Franzelfx/vertical-wind-turbine/datasheets/README.md

# Datasheets

| File | Part | Revision |
| --- | --- | --- |
| `datasheets/bq25798-SLUSDV2C.pdf` | TI BQ25798 | SLUSDV2C, June 2026 |
| `datasheets/ap63203-diodes.pdf` | Diodes AP63203 | as downloaded 2026-11-06 |

Others to add when parts are chosen (`plans/electronics.md`, E2).
