Franzelfx/vertical-wind-turbine/firmware/README.md

# Firmware

Nothing here yet: `plans/electronics.md`, phase E4. ESP32-C3 on the charge board, see ADR-007.

The board charges without firmware, at the charger's defaults, and is protected without it (ADR-006).
