Franzelfx/vertical-wind-turbine/plans/requirements.md

# Requirements

> Generated by `uv run vawt docs` from `src/vawt/system/requirements.py`; do not edit by hand. Change a
> requirement there. `tests/test_requirements.py` fails when a limit is broken.

Goal: charge a 3S Li-ion pack from a small printed turbine on an 80 x 80 mm, 3 m wooden pier, with
everything needed in one weatherproof enclosure.

Evidence: **M** measured from a real file, **S** from a named source, **E** an estimate. Everything
holds on paper only: nothing has been built yet.

| ID | Requirement | Limit | Now | Holds | Evidence |
| --- | --- | --- | --- | --- | --- |
| SYS1 | Charge voltage: 3S Li-ion, the `12 V` pack in the brief | <= 12.6 V | 12.6 V | yes | S |
| SYS2 | Mean wind fills the pack in | <= 14 days | 7.349 days | yes | E |
| SYS3 | Pack drain with the rotor standing: charger, regulator, MCU, BMS | <= 1 mW | 0.5457 mW | yes | E |
| SYS4 | Wind at which charging begins | <= 4 m/s | 2.8 m/s | yes | E |
| SYS5 | Wind at which the rotor starts against cogging and drag | <= 3 m/s | 2.129 m/s | yes | E |
| ELE1 | Relay trips below the charger's overvoltage stop | <= 26 V | 22.5 V | yes | E |
| ELE2 | Open-circuit bus at survival wind, within the 100 V parts | <= 100 V | 70.8 V | yes | E |
| ELE3 | Relay series resistors at survival wind | <= 9 W | 5.762 W | yes | E |
| ELE4 | Generator current at peak power, within the motor's rating | <= 1.5 A | 1.031 A | yes | E |
| ELE5 | Generator copper loss at peak power | <= 12 W | 11.7 W | yes | E |
| ELE6 | Charger input current at peak power | <= 3.3 A | 1.031 A | yes | S |
| MEC1 | Rotor tip to pier face | >= 15 mm | 17.5 mm | yes | M |
| MEC2 | Rotor underside above ground, out of reach | >= 2000 mm | 2010 mm | yes | M |
| MEC3 | Longest printed enclosure part on the print bed | <= 256 mm | 244 mm | yes | M |
| MEC4 | Enclosure screws stay on the pier's face | <= 80 mm | 72.5 mm | yes | M |
| MEC5 | Pier utilisation at survival wind, EN 1995 style | <= 1 | 0.6853 | yes | E |
| MEC6 | Swing at the rotor when imbalance sits on the pier's first mode | <= 5 mm | 1.26 mm | yes | E |
| MEC7 | Bracket arm bending at survival wind, ASA with layer knock-down | <= 10 MPa | 2.415 MPa | yes | E |
| MEC8 | M8 stub bending at survival wind, A2-70 | <= 200 MPa | 40.3 MPa | yes | E |
| MEC9 | Wind at which a free-running rotor reaches its speed limit: lock it above | >= 20 m/s | 24.05 m/s | yes | E |
| ENC1 | Gasket squeeze, lower bound | >= 20 % | 26.67 % | yes | M |
| ENC2 | Gasket squeeze, upper bound | <= 35 % | 26.67 % | yes | M |
| ENC3 | Tallest board part to the lid's inner face | >= 5 mm | 22.9 mm | yes | M |
