Franzelfx/vertical-wind-turbine/docs/assumptions.md

# Assumptions

> Generated by `uv run vawt docs` from the `ASSUMPTION` comments in `src/vawt/spec.py`; do not edit by
> hand (`tests/test_docs.py` fails when this page and the code drift apart).

Each line is a number nobody has measured. `plans/bench.md` names each test.

| Value | Assumption and the test that replaces it |
| --- | --- |
| `mean_wind_m_s = 3.5` | 3 m mast in a garden; replace with a site log (B5) |
| `survival_wind_m_s = 30.0` | 11 Bft gust, typical inland Germany upper bound |
| `cp_max = 0.12` | replace with the torque-speed curve from bench test B3 |
| `tsr_opt = 0.8` | typical of drag rotors; B3 |
| `tsr_no_load = 1.6` | twice tsr_opt, parabolic model; B3 |
| `max_rpm = 3000.0` | bench spin test B4 sets the real limit |
| `damping_q = 20.0` | timber pier, about 2.5 % damping; B5 |
| `imbalance_g_mm = 500.0` | 5 g at 100 mm for an unbalanced print; B4 |
| `resistance_ll_ohm = 11.0` | no published figure found; measure, B1 |
| `inductance_ll_h = 0.005` | B1 |
| `cogging_nm = 0.012` | low for a 24N22P gimbal motor; B1 |
| `drag_nm = 0.010` | three bearings plus iron loss; B1 |
| `copper_limit_w = 12.0` | thermal limit of a 124 g motor in free air; B2 |
| `efficiency = 0.85` | at light load and large step; B2 |
| `cell_ah = 3.5` | LG MJ1 / Samsung 35E class; check the bought pack |
| `phone_wh = 15.0` | a typical smartphone battery; a yardstick only |
| `solar_kwh_per_kwp = 950.0` | fixed panel in Germany; a yardstick only |
| `electricity_eur_kwh = 0.35` | German household price; a yardstick only |
