Franzelfx/vertical-wind-turbine/docs/sizing.md

# Sizing

> Generated by `uv run vawt docs` from `src/vawt/system/sizing.py` and `src/vawt/spec.py`; do not
> edit by hand (`tests/test_docs.py` fails when this page and the code drift apart).

**Accuracy: treat every power figure as +-50 % until bench tests B1 and B3 (`plans/bench.md`) replace
the rotor and generator assumptions.** Nothing has been built yet.

## Rotor and generator

Rotor: 245 mm x 890 mm, swept 0.216 m2,
1.69 kg at the slicer's settings. Cp 0.12 at tip speed ratio
0.8. Generator: GM4108H-120T, 52.85 rpm/V,
11 ohm line to line.

Starts at 2.1 m/s, charges from 2.8 m/s.

Best point with ideal input-voltage tracking, inside every limit: the charger's 3.6 V
minimum, the relay's 22.5 V trip, and the generator's 1.5 A and 12 W copper limits:

| Wind (m/s) | Rotor (rpm) | Torque (N m) | Current (A) | Bus (V) | Copper loss (W) | Into the pack (W) |
| --- | --- | --- | --- | --- | --- | --- |
| 3 | 252 | 0.004 | 0.02 | 3.6 | 0.0 | 0.1 |
| 4 | 304 | 0.020 | 0.11 | 3.6 | 0.1 | 0.3 |
| 5 | 406 | 0.032 | 0.18 | 4.8 | 0.4 | 0.7 |
| 6 | 513 | 0.045 | 0.25 | 6.1 | 0.7 | 1.3 |
| 8 | 731 | 0.073 | 0.40 | 8.5 | 1.8 | 2.9 |
| 10 | 956 | 0.103 | 0.57 | 10.9 | 3.6 | 5.2 |
| 12 | 1184 | 0.136 | 0.75 | 13.2 | 6.2 | 8.3 |
| 15 | 1534 | 0.187 | 1.03 | 16.8 | 11.7 | 14.5 |
| 18 | 0 | 0.000 | 0.00 | 0.0 | 0.0 | 0.0 |
| 20 | 0 | 0.000 | 0.00 | 0.0 | 0.0 | 0.0 |

**Peak: 19.1 W into the pack, at 17.0 m/s.** Charging runs from 2.8 to 17.1 m/s. Above about 10 m/s the generator limits the output, not the rotor: its resistance would turn more power into heat than the motor can shed, so firmware lets the rotor run faster at lower torque.

## Yield

Rayleigh wind distribution. The site assumption is 3.5 m/s mean: a 3 m pole in a
garden. A site log (B5) replaces it. Pack: 76 Wh.

| Mean wind (m/s) | Mean power (W) | Energy (kWh/year) | Days to fill the pack |
| --- | --- | --- | --- |
| 2.5 | 0.13 | 1.1 | 25 |
| 3.5 | 0.43 | 3.8 | 7 |
| 4.5 | 0.93 | 8.2 | 3 |
| 5.5 | 1.64 | 14.4 | 2 |

## Overvoltage

The free-running rotor drives the bus past the charger's 24 V at
10.2 m/s, which happens whenever the pack is full, and reaches
71 V at 30 m/s. The relay trips at
22.5 V, below the charger's 26 V stop (ADR-006). Its coil path
draws 144 mW at a 12 V bus, about 2 % of what the rotor makes there.

## Stopping the rotor

The brake switch shorts the bus through 4.7 ohm. It only slows the rotor: at 10 m/s
it holds 817 rpm with 9.5 W in the generator, and the
generator's 12 W limit is reached at 10.9 m/s.
Free-running, the rotor reaches its assumed 3000 rpm limit at
24.1 m/s. **Lock it with the parking pin before a forecast
storm (ADR-005).**

## Structure, at 30 m/s

| Item | Value |
| --- | --- |
| Rotor drag | 143 N |
| Pier drag | 198 N |
| Moment at the pier's base | 648 N m |
| Bending stress at the base | 7.6 MPa |
| Pier utilisation | 0.69 |
| Deflection at rotor height | 33 mm |
| Bracket arm stress | 2.4 MPa |
| M8 stub stress | 40 MPa |

## Vibration

The pier's first mode is 4.9 Hz, which is 296 rpm. The rotor
reaches that speed at 4.7 m/s at its best tip speed ratio, inside the everyday
range. With the assumed 500 g mm of imbalance the swing is
1.3 mm at resonance, small but continuous at the wind you will see most.
Balance the rotor (B4). If it shakes, guy wires move the mode to about
31 Hz, near the rotor's running range at high wind, so check
again then. Assumed: Q = 20.

## Power budget with no wind

0.55 mW from the pack: 76 Wh lasts
5772 days. Li-ion's own self-discharge is the larger term.

Charging stops outside 0-45 degC, by the NTC on
the pack (TS pin). In a German winter that means no charging on frosty days.
