Franzelfx/vertical-wind-turbine/docs/bom.md

# Board parts

> Generated by `tools/bom.py` from the KiCad netlist and JLCPCB's public catalogue; do not edit by hand
> (`tests/test_electronics.py` fails when a part in the schematic is missing here).

Stock and prices as of 2026-11-06, single-unit tier.

**Parts total: about 11.83 USD per board**, without the fab, assembly, and what is listed below.
Datasheet checks so far: ADR-007.

| Parts | Qty | Value | LCSC | Manufacturer's part | Stock | Unit price (USD) | Line |
| --- | --- | --- | --- | --- | --- | --- | --- |
| C1 | 1 | 100n 100V | C107181 | CC1206KKX7R0BB104 | 68,519 | 0.0402 | 0.04 |
| C13 C14 C15 C16 C17 C19 C20 C23 C24 C28 | 10 | 10u 25V | C5448891 | TCC0805X5R106K250FT | 183,339 | 0.0290 | 0.29 |
| C12 C18 C2 C22 C29 C8 | 6 | 100n | C14663 | CC0603KRX7R9BB104 | 34,754,599 | 0.0093 | 0.06 |
| C21 | 1 | 1n 50V | C100040 | CC0603KRX7R9BB102 | 2,016,034 | 0.0085 | 0.01 |
| C25 C26 | 2 | 22u | C380336 | TCC0805X5R226K100FT | 79,273 | 0.0477 | 0.10 |
| C27 | 1 | 1u | C1592 | CL10A105KO8NNNC | 1,921,364 | 0.0109 | 0.01 |
| C3 C4 | 2 | 47n | C107093 | CC0603KRX7R9BB473 | 1,311,137 | 0.0083 | 0.02 |
| C5 | 1 | 4u7 | C380325 | TCC0603X5R475K160CT | 945,252 | 0.0109 | 0.01 |
| C10 C11 C6 C7 C9 | 5 | 10u 35V | C6119957 | CGA1206X5R106K350NT | 17,421 | 0.0878 | 0.44 |
| D1 D2 D3 D4 D5 D6 | 6 | SS510 | C19229 | SS510C | 24,495 | 0.1137 | 0.68 |
| D10 | 1 | MMSZ5225B | C22399894 | MMSZ5225B | 14,811 | 0.0190 | 0.02 |
| D11 | 1 | green | C12624 | KT-0603G | 348,198 | 0.0119 | 0.01 |
| D7 | 1 | 1SMB5927B | C53171 | 1SMB5927BT3G | 31,381 | 0.1377 | 0.14 |
| D8 | 1 | MMSZ5240B | C151060 | MMSZ5240B-7-F | 40,197 | 0.0277 | 0.03 |
| D9 | 1 | SMBJ26CA | C123932 | SMBJ26CA | 97,352 | 0.0398 | 0.04 |
| J1 | 1 | GENERATOR | C474953 | KF128-5.08-3P-AA | 17,624 | 0.3175 | 0.32 |
| J2 J4 J5 | 3 | BRAKE | C474952 | KF128-5.08-2P-AA | 74,170 | 0.1927 | 0.58 |
| J3 | 1 | PACK_NTC | C158012 | B2B-XH-A(LF)(SN) | 597,562 | 0.0408 | 0.04 |
| J6 | 1 | USB-C | C165948 | TYPE-C-31-M-12 | 322,268 | 0.1870 | 0.19 |
| K1 | 1 | SRD-12VDC-SL-C | C30431 | SRD-12VDC-SL-C | 177,893 | 0.4421 | 0.44 |
| L1 | 1 | 2u2 8A | C408345 | MWSA0518S-2R2MT | 1,977 | 0.1556 | 0.16 |
| L2 | 1 | 4u7 2A | C408337 | MWSA0402S-4R7MT | 39,284 | 0.1500 | 0.15 |
| Q1 | 1 | BSS123 | C78962 | BSS123,215 | 194,333 | 0.0392 | 0.04 |
| Q2 | 1 | AO3400A | C20917 | AO3400A | 1,077,046 | 0.0889 | 0.09 |
| R10 | 1 | 100R | C22775 | 0603WAF1000T5E | 9,237,668 | 0.0021 | 0.00 |
| R11 | 1 | 13.7k | C22793 | 0603WAF1372T5E | 57,455 | 0.0016 | 0.00 |
| R12 | 1 | 5.23k | C23068 | 0603WAF5231T5E | 37,334 | 0.0020 | 0.00 |
| R13 | 1 | 30.1k | C23000 | 0603WAF3012T5E | 36,156 | 0.0016 | 0.00 |
| R14 R15 R16 R17 R19 R20 R21 R22 | 8 | 10k | C25804 | 0603WAF1002T5E | 42,888,502 | 0.0024 | 0.02 |
| R18 | 1 | 1k | C21190 | 0603WAF1001T5E | 27,627,900 | 0.0017 | 0.00 |
| R23 R24 | 2 | 5.1k | C23186 | 0603WAF5101T5E | 20,424,142 | 0.0015 | 0.00 |
| R4 R6 R8 | 3 | 1M | C22935 | 0603WAF1004T5E | 4,463,341 | 0.0018 | 0.01 |
| R5 | 1 | 100k | C25803 | 0603WAF1003T5E | 16,284,196 | 0.0029 | 0.00 |
| R7 | 1 | 33k | C4216 | 0603WAF3302T5E | 3,066,011 | 0.0021 | 0.00 |
| R9 | 1 | 47k | C25819 | 0603WAF4702T5E | 3,025,518 | 0.0016 | 0.00 |
| SW1 | 1 | BOOT | C221880 | PTS645SM43SMTR92LFS | 1,961 | 0.3766 | 0.38 |
| U1 | 1 | BQ25798 | C2876593 | BQ25798RQMR | 9,025 | 2.8682 | 2.87 |
| U2 | 1 | AP63203WU | C780769 | AP63203WU-7 | 5,619 | 1.3457 | 1.35 |
| U3 | 1 | ESP32-C3-WROOM-02 | C2934560 | ESP32-C3-WROOM-02-N4 | 13,503 | 3.3118 | 3.31 |

## Not at JLCPCB

Hand-fitted, from a distributor. Fuse holders are still open (`plans/electronics.md`, E2).

| Parts | Qty | Value | Footprint |
| --- | --- | --- | --- |
| F1 | 1 | 7.5A mini blade | Fuse_Blade_Mini_directSolder |
| F2 | 1 | 5A mini blade | Fuse_Blade_Mini_directSolder |
| R1 R2 R3 | 3 | 1.8k 3W | R_Axial_DIN0516_L15.5mm_D5.0mm_P20.32mm_Horizontal |
