Franzelfx/vertical-wind-turbine/docs/printing.md

# Printing

> Generated by `tools/build-cad.sh` from `cad/freecad/build.py`; do not edit by hand
> (`tests/test_cad.py` fails when this page and the build drift apart).

For this project's own parts. STEP and STL land in `build/cad/`. All fit a 256 mm bed.

| Part | Qty | Material | How it lies | Size (mm) | Volume (cm3) | Supports |
| --- | --- | --- | --- | --- | --- | --- |
| `tub` | 1 | ASA | back on the bed, opening up | 244 x 148 x 43 | 260.9 | no |
| `lid` | 1 | ASA | front on the bed, opening up | 208 x 148 x 15 | 158.2 | no |
| `rain_hood` | 1 | ASA | roof on the bed | 164 x 76 x 24 | 52.8 | no |
| `standoff` | 4 | ASA | flat | 18 x 18 x 8 | 1.8 | no |
| `drive_flange` | 1 | ASA | skirt on the bed, boss up | 60 x 60 x 21 | 26.3 | yes, 2189 mm2 |
| `drive_bracket` | 1 | ASA | top flange on the bed: layers run along the arm, its strong way | 176 x 120 x 73 | 243.4 | yes, 3489 mm2 |
| `motor_plate` | 1 | ASA | flat | 73 x 73 x 6 | 23.8 | no |
| `generator_cover` | 1 | ASA | floor on the bed | 81 x 81 x 73 | 55.7 | no |
| `coupling` | 1 | TPU 95A | pins up | 34 x 34 x 25 | 19.8 | yes, 593 mm2 |

The check counts surfaces leaning more than 46 degrees from vertical, facing down, off the bed. Parts marked "no" have
only short bridges: hole tops, the gasket groove, the lid's 1 mm ledge. Print enclosure parts with at
least 4 perimeters, for sealing (ADR-008). Rotor printing: `docs/hardware.md`.
