Franzelfx/vertical-wind-turbine/electronics/charge-board/charge-board.kicad_pcb

## KiCad design electronics/charge-board/charge-board.kicad_pcb (2026-11-06)

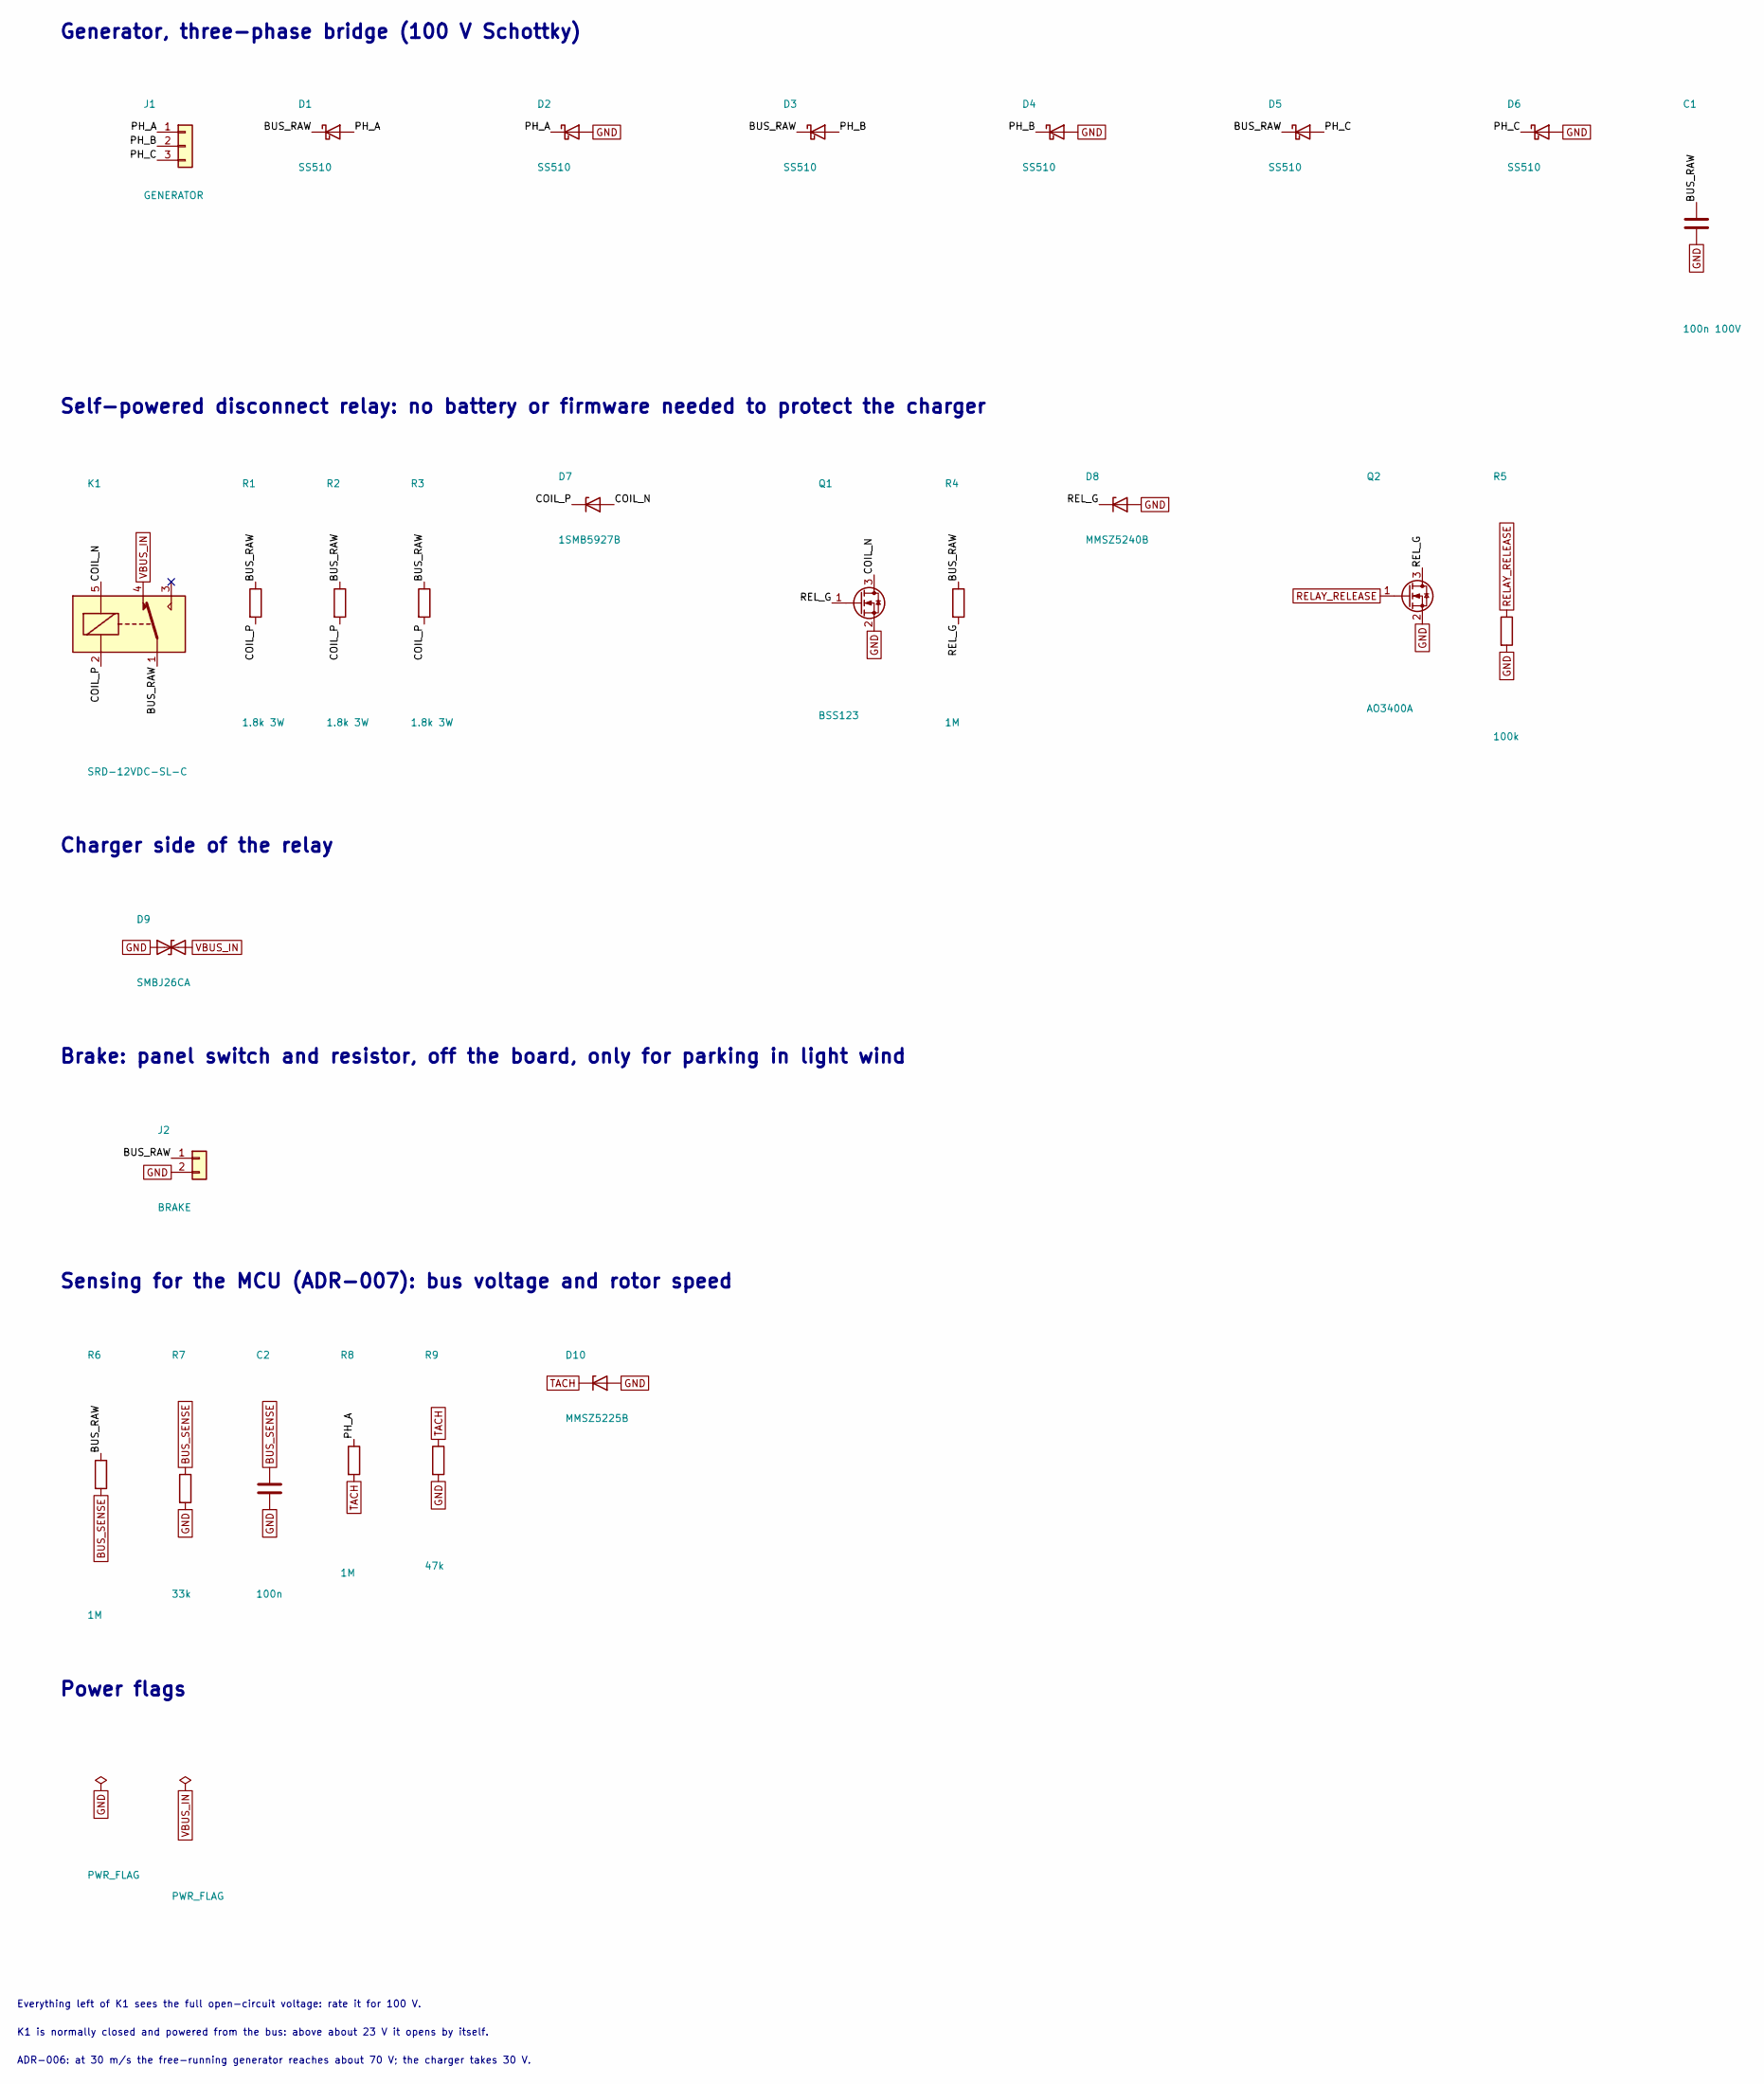
[picture p1: schematic input_stage.kicad_sch, Input stage]

Parts:
C1: 100n 100V; C_1206_3216Metric; LCSC Part C107181
C2: 100n; C_0603_1608Metric; LCSC Part C14663
D1, D2, D3, D4, D5, D6: SS510; D_SMC; LCSC Part C19229
D7: 1SMB5927B; D_SMB; LCSC Part C53171
D8: MMSZ5240B; D_SOD-123; LCSC Part C151060
D9: SMBJ26CA; D_SMB; LCSC Part C123932
D10: MMSZ5225B; D_SOD-123; LCSC Part C22399894
J1: GENERATOR; TerminalBlock_Phoenix_MKDS-1,5-3-5.08_1x03_P5.08mm_Horizont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; LCSC Part C474953
J2: BRAKE; TerminalBlock_Phoenix_MKDS-1,5-2-5.08_1x02_P5.08mm_Horizont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; LCSC Part C474952
K1: SRD-12VDC-SL-C; Relay_SPDT_SANYOU_SRD_Series_Form_C; LCSC Part C30431
Q1: BSS123; SOT-23; LCSC Part C78962
Q2: AO3400A; SOT-23; LCSC Part C20917
R1, R2, R3: 1.8k 3W; R_Axial_DIN0516_L15.5mm_D5.0mm_P20.32mm_Horizontal
R4, R6, R8: 1M; R_0603_1608Metric; LCSC Part C22935
R5: 100k; R_0603_1608Metric; LCSC Part C25803
R7: 33k; R_0603_1608Metric; LCSC Part C4216
R9: 47k; R_0603_1608Metric; LCSC Part C25819

Connections:
/Input stage/BUS_RAW: C1.1, D1.1 (K), D3.1 (K), D5.1 (K), J2.1, K1.1, R1.1, R2.1, R3.1, R4.1, R6.1
/Input stage/COIL_N: D7.2 (A), K1.5, Q1.3 (D)
/Input stage/COIL_P: D7.1 (K), K1.2, R1.2, R2.2, R3.2
/Input stage/PH_A: D1.2 (A), D2.1 (K), J1.1, R8.1
/Input stage/PH_B: D3.2 (A), D4.1 (K), J1.2
/Input stage/PH_C: D5.2 (A), D6.1 (K), J1.3
/Input stage/REL_G: D8.1 (K), Q1.1 (G), Q2.3 (D), R4.2
BUS_SENSE: C2.1, R6.2, R7.1; also elsewhere on the board
GND: C1.2, C2.2, D2.2 (A), D4.2 (A), D6.2 (A), D8.2 (A), D9.1 (A1), D10.2 (A), J2.2, Q1.2 (S), Q2.2 (S), R5.2, R7.2, R9.2; also elsewhere on the board
RELAY_RELEASE: Q2.1 (G), R5.1; also elsewhere on the board
TACH: D10.1 (K), R8.2, R9.1; also elsewhere on the board
VBUS_IN: D9.2 (A2), K1.4; also elsewhere on the board

Notes on the sheet:
Generator, three-phase bridge (100 V Schottky)
Self-powered disconnect relay: no battery or firmware needed to protect the charger
Charger side of the relay
Brake: panel switch and resistor, off the board, only for parking in light wind
Sensing for the MCU (ADR-007): bus voltage and rotor speed
Power flags
ADR-006: at 30 m/s the free-running generator reaches about 70 V; the charger takes 30 V.
K1 is normally closed and powered from the bus: above about 23 V it opens by itself.
Everything left of K1 sees the full open-circuit voltage: rate it for 100 V.

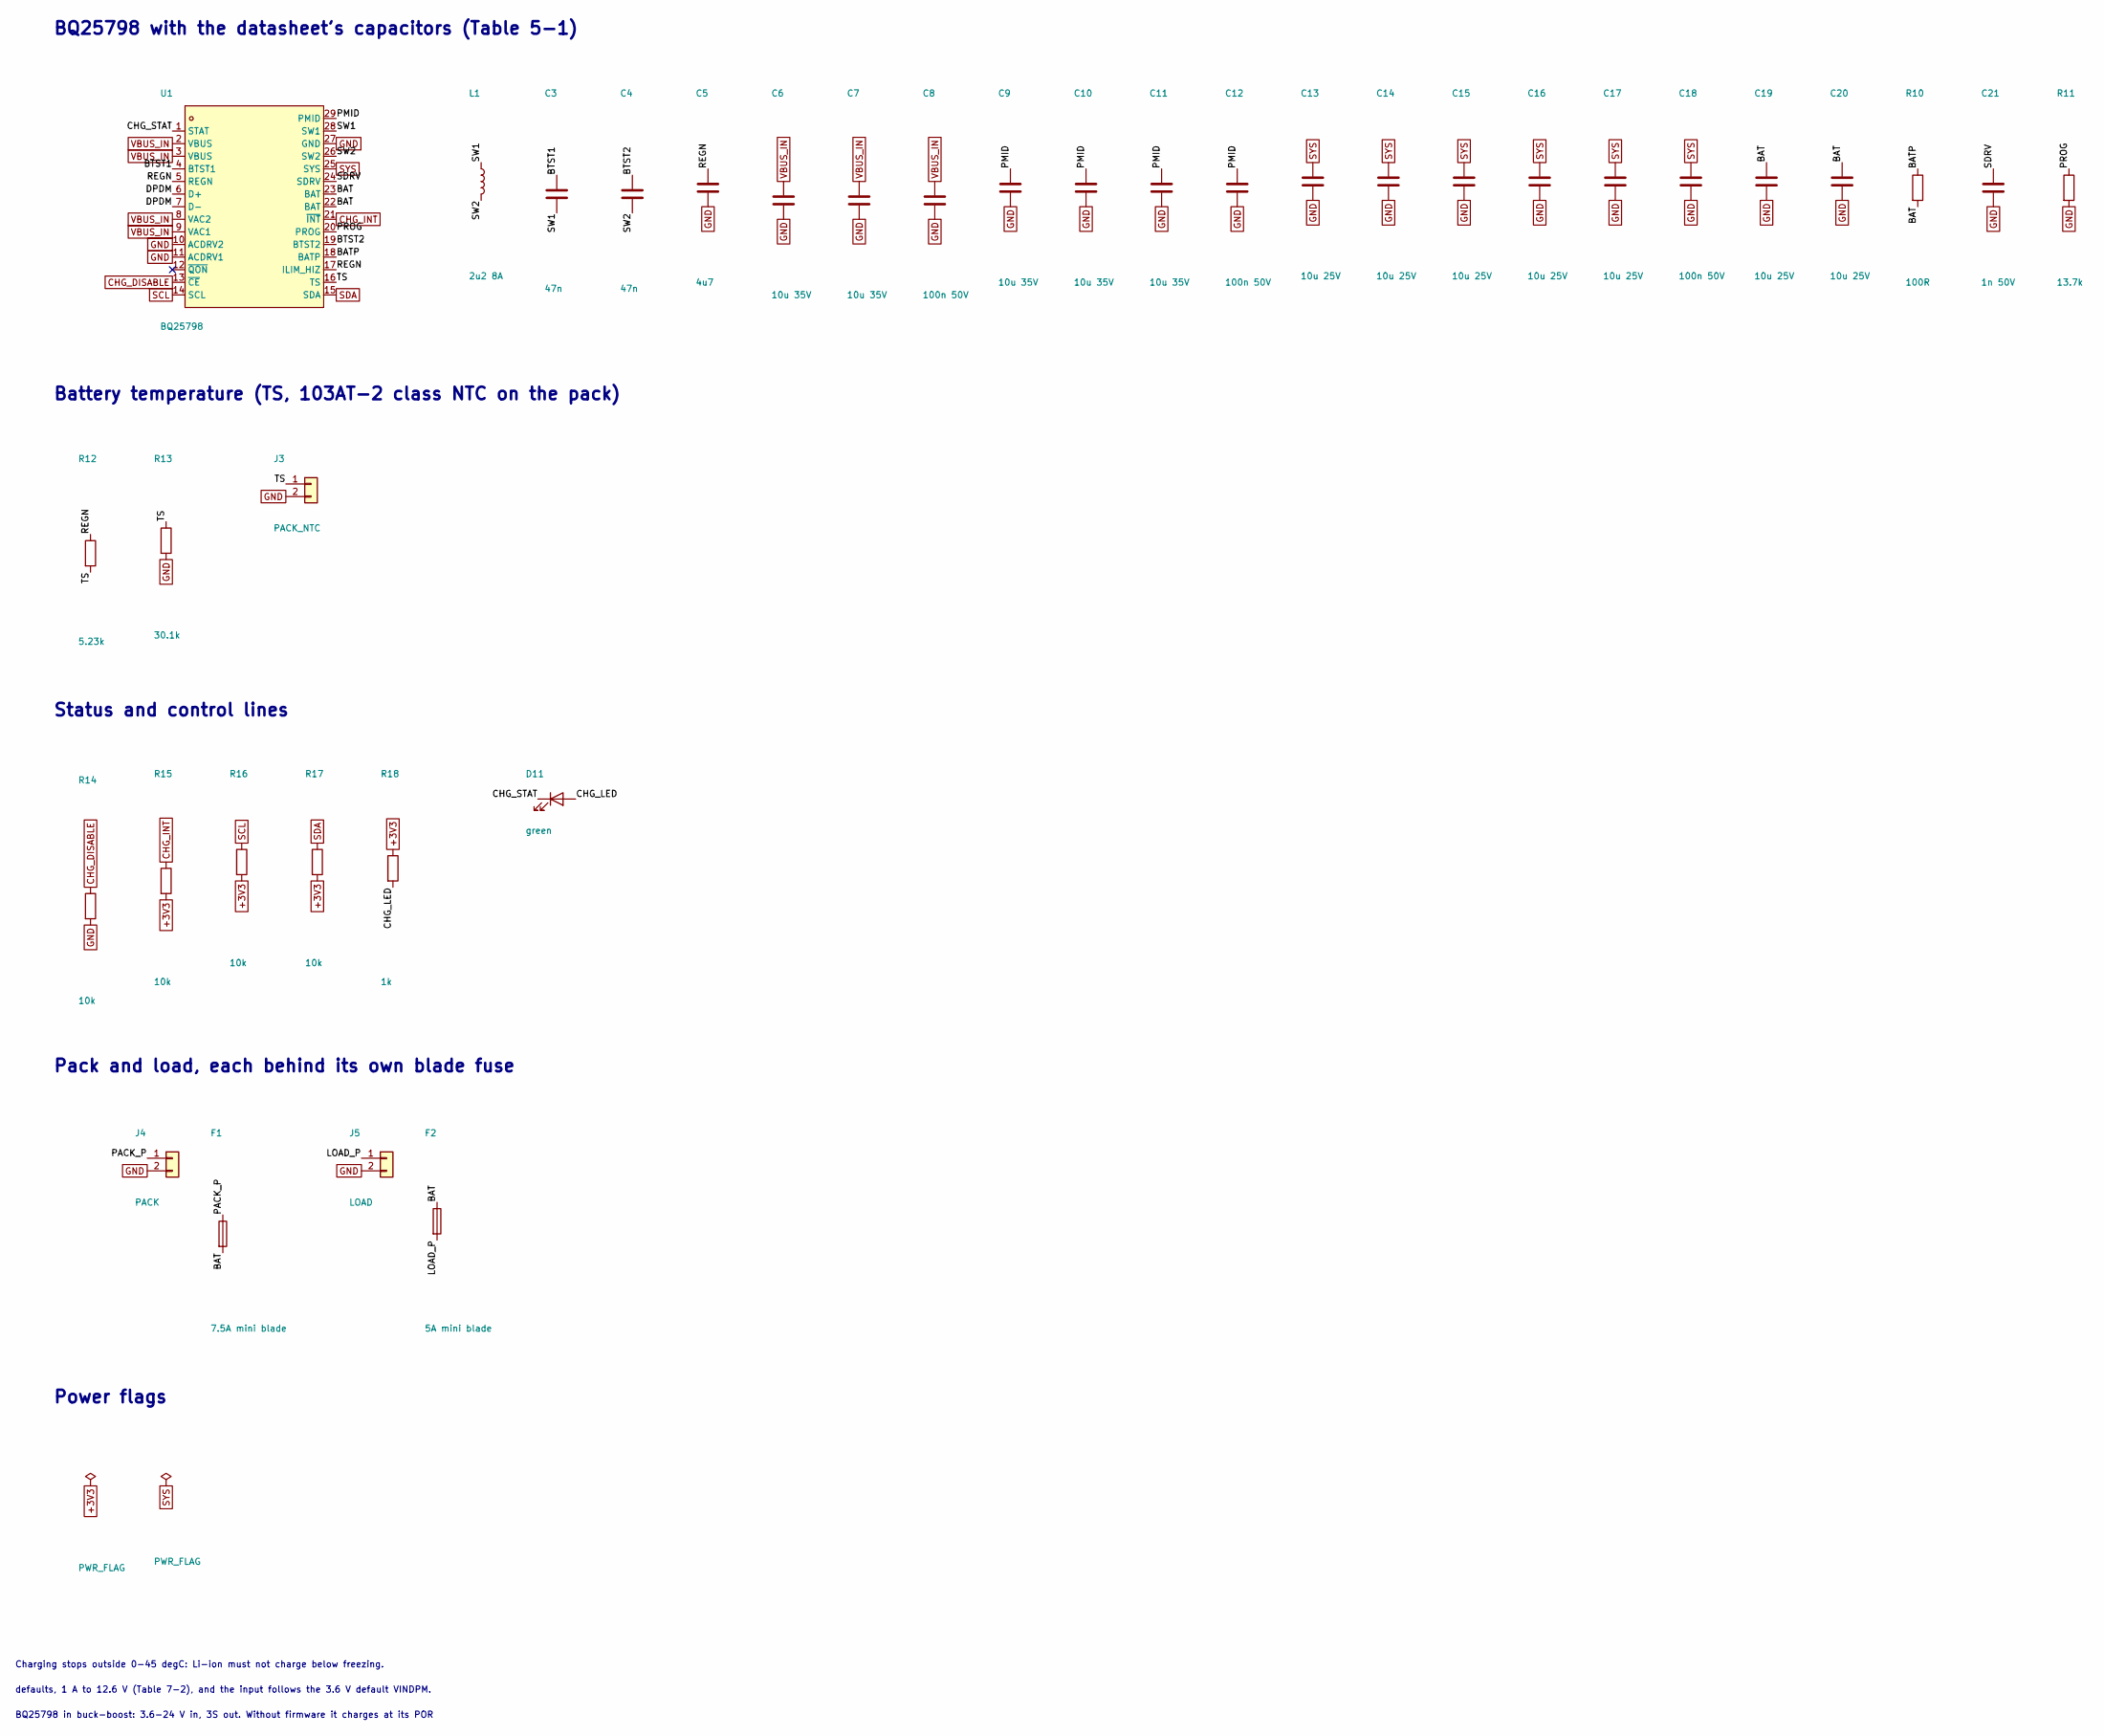
[picture p2: schematic charger.kicad_sch]

Parts:
C3, C4: 47n; C_0603_1608Metric; LCSC Part C107093
C5: 4u7; C_0603_1608Metric; LCSC Part C380325
C6, C7, C9, C10, C11: 10u 35V; C_1206_3216Metric; LCSC Part C6119957
C8, C12, C18: 100n 50V; C_0603_1608Metric; LCSC Part C14663
C13, C14, C15, C16, C17, C19, C20: 10u 25V; C_0805_2012Metric; LCSC Part C5448891
C21: 1n 50V; C_0603_1608Metric; LCSC Part C100040
D11: green; LED_0603_1608Metric; LCSC Part C12624
F1: 7.5A mini blade; Fuse_Blade_Mini_directSolder
F2: 5A mini blade; Fuse_Blade_Mini_directSolder
J3: PACK_NTC; JST_XH_B2B-XH-A_1x02_P2.50mm_Vertical; LCSC Part C158012
J4: PACK; TerminalBlock_Phoenix_MKDS-1,5-2-5.08_1x02_P5.08mm_Horizont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; LCSC Part C474952
J5: LOAD; TerminalBlock_Phoenix_MKDS-1,5-2-5.08_1x02_P5.08mm_Horizont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; LCSC Part C474952
L1: 2u2 8A; L_Sunlord_MWSA0518S; LCSC Part C408345
R10: 100R; R_0603_1608Metric; LCSC Part C22775
R11: 13.7k; R_0603_1608Metric; LCSC Part C22793
R12: 5.23k; R_0603_1608Metric; LCSC Part C23068
R13: 30.1k; R_0603_1608Metric; LCSC Part C23000
R14, R15, R16, R17: 10k; R_0603_1608Metric; LCSC Part C25804
R18: 1k; R_0603_1608Metric; LCSC Part C21190
U1: BQ25798; QFN-29_L4.0-W4.0-P0.40-TL-BQ25792RQMR; LCSC Part C2876593

Connections:
+3V3: R15.2, R16.2, R17.2, R18.1; also elsewhere on the board
/Charger/BAT: C19.1, C20.1, F1.2, F2.1, R10.2, U1.22 (BAT), U1.23 (BAT)
/Charger/BATP: R10.1, U1.18 (BATP)
/Charger/BTST1: C3.1, U1.4 (BTST1)
/Charger/BTST2: C4.1, U1.19 (BTST2)
/Charger/CHG_LED: D11.2 (A), R18.2
/Charger/CHG_STAT: D11.1 (K), U1.1 (STAT)
/Charger/DPDM: U1.6 (D+), U1.7 (D-)
/Charger/LOAD_P: F2.2, J5.1
/Charger/PACK_P: F1.1, J4.1
/Charger/PMID: C9.1, C10.1, C11.1, C12.1, U1.29 (PMID)
/Charger/PROG: R11.1, U1.20 (PROG)
/Charger/REGN: C5.1, R12.1, U1.5 (REGN), U1.17 (ILIM_HIZ)
/Charger/SDRV: C21.1, U1.24 (SDRV)
/Charger/SW1: C3.2, L1.1, U1.28 (SW1)
/Charger/SW2: C4.2, L1.2, U1.26 (SW2)
/Charger/TS: J3.1, R12.2, R13.1, U1.16 (TS)
CHG_DISABLE: R14.1, U1.13 (~CE); also elsewhere on the board
CHG_INT: R15.1, U1.21 (~INT); also elsewhere on the board
GND: C5.2, C6.2, C7.2, C8.2, C9.2, C10.2, C11.2, C12.2, C13.2, C14.2, C15.2, C16.2, C17.2, C18.2, C19.2, C20.2, C21.2, J3.2, J4.2, J5.2, R11.2, R13.2, R14.2, U1.10 (ACDRV2), U1.11 (ACDRV1), U1.27 (GND); also elsewhere on the board
SCL: R16.1, U1.14 (SCL); also elsewhere on the board
SDA: R17.1, U1.15 (SDA); also elsewhere on the board
SYS: C13.1, C14.1, C15.1, C16.1, C17.1, C18.1, U1.25 (SYS); also elsewhere on the board
VBUS_IN: C6.1, C7.1, C8.1, U1.2 (VBUS), U1.3 (VBUS), U1.8 (VAC2), U1.9 (VAC1); also elsewhere on the board

Notes on the sheet:
BQ25798 with the datasheet's capacitors (Table 5-1)
Battery temperature (TS, 103AT-2 class NTC on the pack)
Status and control lines
Pack and load, each behind its own blade fuse
Power flags
BQ25798 in buck-boost: 3.6-24 V in, 3S out. Without firmware it charges at its POR
defaults, 1 A to 12.6 V (Table 7-2), and the input follows the 3.6 V default VINDPM.
Charging stops outside 0-45 degC: Li-ion must not charge below freezing.

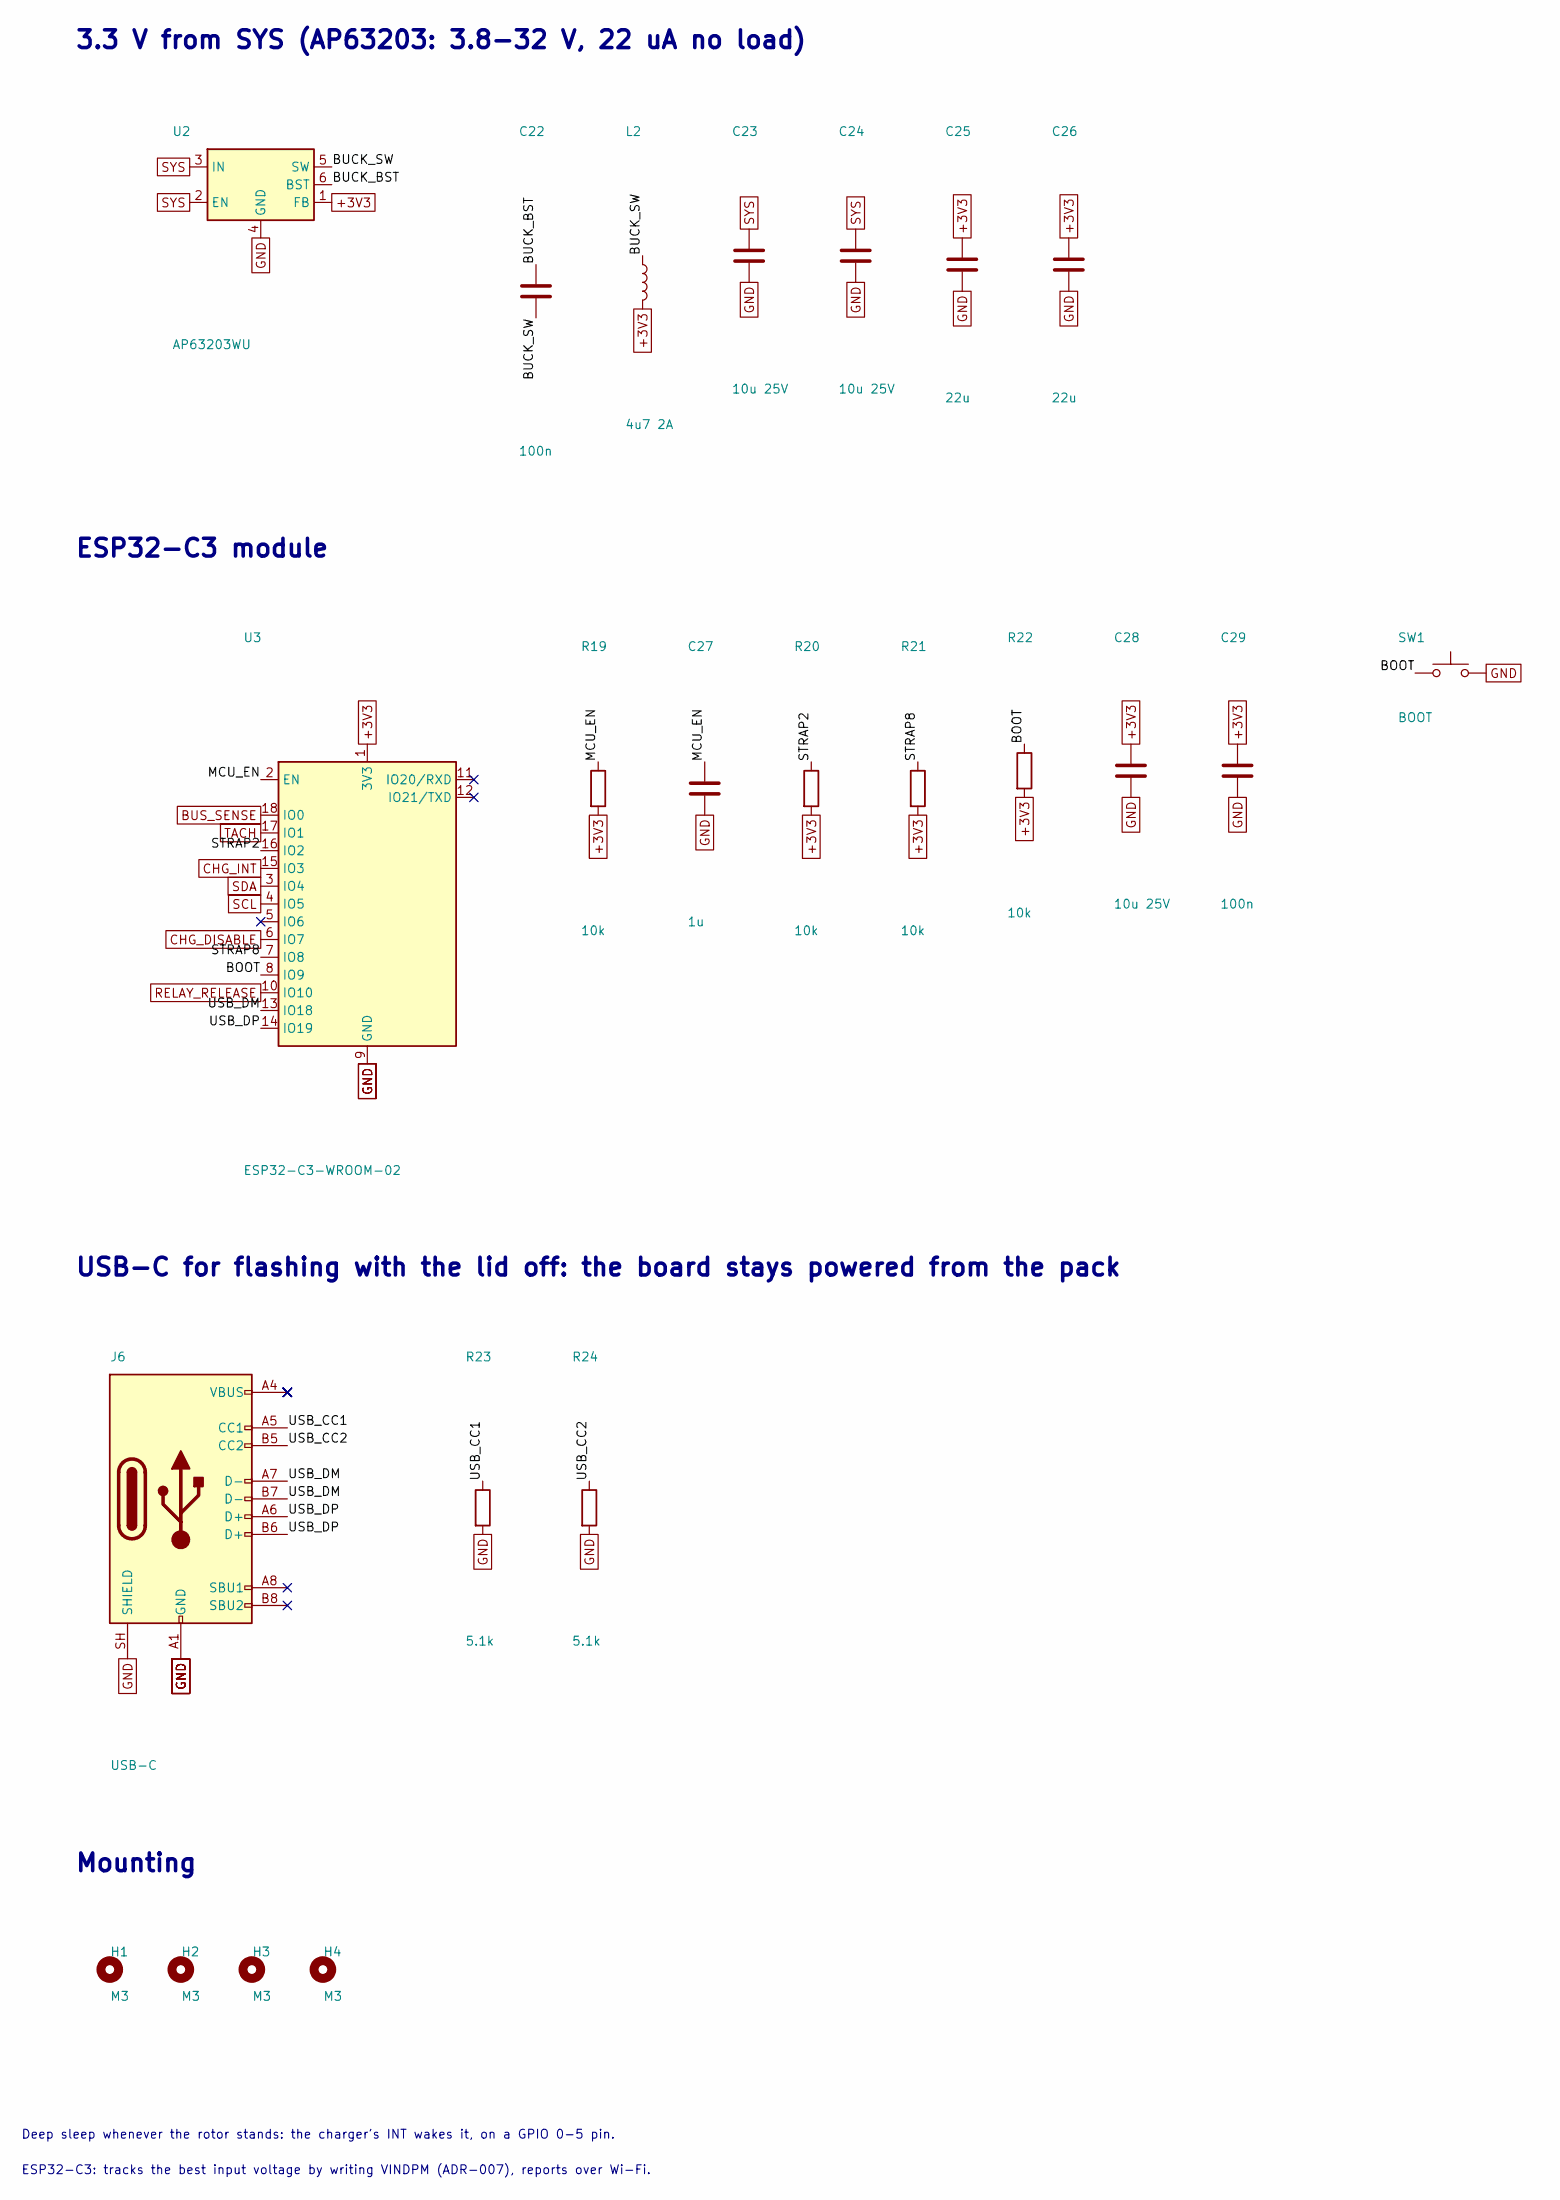
[picture p3: schematic controller.kicad_sch]

Parts:
C22, C29: 100n; C_0603_1608Metric; LCSC Part C14663
C23, C24, C28: 10u 25V; C_0805_2012Metric; LCSC Part C5448891
C25, C26: 22u; C_0805_2012Metric; LCSC Part C380336
C27: 1u; C_0603_1608Metric; LCSC Part C1592
H1, H2, H3, H4: M3; MountingHole_3.2mm_M3
J6: USB-C; USB_C_Receptacle_HRO_TYPE-C-31-M-12; LCSC Part C165948
L2: 4u7 2A; L_Sunlord_MWSA0402S; LCSC Part C408337
R19, R20, R21, R22: 10k; R_0603_1608Metric; LCSC Part C25804
R23, R24: 5.1k; R_0603_1608Metric; LCSC Part C23186
SW1: BOOT; SW_SPST_PTS645Sx43SMTR92; LCSC Part C221880
U2: AP63203WU; TSOT-23-6; LCSC Part C780769
U3: ESP32-C3-WROOM-02; LCSC Part C2934560

Connections:
+3V3: C25.1, C26.1, C28.1, C29.1, L2.2, R19.2, R20.2, R21.2, R22.2, U2.1 (FB), U3.1 (3V3); also elsewhere on the board
/Controller/BOOT: R22.1, SW1.1, U3.8 (IO9)
/Controller/BUCK_BST: C22.1, U2.6 (BST)
/Controller/BUCK_SW: C22.2, L2.1, U2.5 (SW)
/Controller/MCU_EN: C27.1, R19.1, U3.2 (EN)
/Controller/STRAP2: R20.1, U3.16 (IO2)
/Controller/STRAP8: R21.1, U3.7 (IO8)
/Controller/USB_CC1: J6.A5 (CC1), R23.1
/Controller/USB_CC2: J6.B5 (CC2), R24.1
/Controller/USB_DM: J6.A7 (D-), J6.B7 (D-), U3.13 (IO18)
/Controller/USB_DP: J6.A6 (D+), J6.B6 (D+), U3.14 (IO19)
BUS_SENSE: U3.18 (IO0); also elsewhere on the board
CHG_DISABLE: U3.6 (IO7); also elsewhere on the board
CHG_INT: U3.15 (IO3); also elsewhere on the board
GND: C23.2, C24.2, C25.2, C26.2, C27.2, C28.2, C29.2, J6.A1 (GND), J6.A12 (GND), J6.B1 (GND), J6.B12 (GND), J6.SH (SHIELD), R23.2, R24.2, SW1.2, U2.4 (GND), U3.9 (GND), U3.19 (GND); also elsewhere on the board
RELAY_RELEASE: U3.10 (IO10); also elsewhere on the board
SCL: U3.4 (IO5); also elsewhere on the board
SDA: U3.3 (IO4); also elsewhere on the board
SYS: C23.1, C24.1, U2.2 (EN), U2.3 (IN); also elsewhere on the board
TACH: U3.17 (IO1); also elsewhere on the board

Notes on the sheet:
3.3 V from SYS (AP63203: 3.8-32 V, 22 uA no load)
ESP32-C3 module
USB-C for flashing with the lid off: the board stays powered from the pack
Mounting
ESP32-C3: tracks the best input voltage by writing VINDPM (ADR-007), reports over Wi-Fi.
Deep sleep whenever the rotor stands: the charger's INT wakes it, on a GPIO 0-5 pin.

Board: 4 copper layers, 85 parts (0 on the bottom side), 44 nets, no tracks yet.
