Franzelfx/vertical-wind-turbine/(commit log)

2026-11-06 Project setup: spec, sizing, FreeCAD parts, KiCad board, renders
    M1, E1. Scaffold after PROJECT-PLAYBOOK.md. The rotor is a licensed model and
    stays out of git (ADR-003). Decisions: side mount with a new drive train
    (ADR-004), manual storm pin (ADR-005), self-powered overvoltage relay (ADR-006),
    BQ25798 and ESP32-C3 for a 3S pack (ADR-007), printed ASA enclosure (ADR-008).
    The enclosure and drive train pass collision checks; the schematic passes ERC.
    The board is placed, not routed. No firmware. Nothing is built or measured.
    [charge-board.kicad_pcb, charge-board.kicad_sch, charger.kicad_sch, controller.kicad_sch, input_stage.kicad_sch]
2026-11-06 M1, E2: printable enclosure, checked parts with a BOM, generator limits in the model
    Sizing now stays inside the relay's trip voltage and the generator's current and
    copper limits: peak 19 W at 17 m/s, then the relay opens.
    The print check found real defects: rim flanges and standoff pads that needed
    supports, a hood tab that kept the roof off the bed, and a label recess that was a
    70 mm bridge. Parts declared free of supports now pass it (docs/printing.md).
    Parts checked against stock and the BQ25798 and AP63203 datasheets (ADR-007). About
    12 USD per board for what JLCPCB stocks (docs/bom.md). Open: replaceable fuse holders,
    and the remaining datasheets.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
    [charge-board.kicad_pcb, charger.kicad_sch, controller.kicad_sch, input_stage.kicad_sch]
2026-11-06 M1: photographic renders and a labelled overview
    Real sky with clouds, generated grass and a tree line, depth of field, rounded
    edges, wood grain, galvanised steel and corrugated conduit. A warning sticker takes
    its text from the spec. New shots: the labelled side view and the top bracket.
    Blender's STL import keeps millimetres under a 0.001 object scale, so object-space
    textures had averaged to flat colours. They now use world position.
    [charge-board.kicad_pcb]
